pbaron2/tracker-lora/Tracker_LoRa/test1.PNG

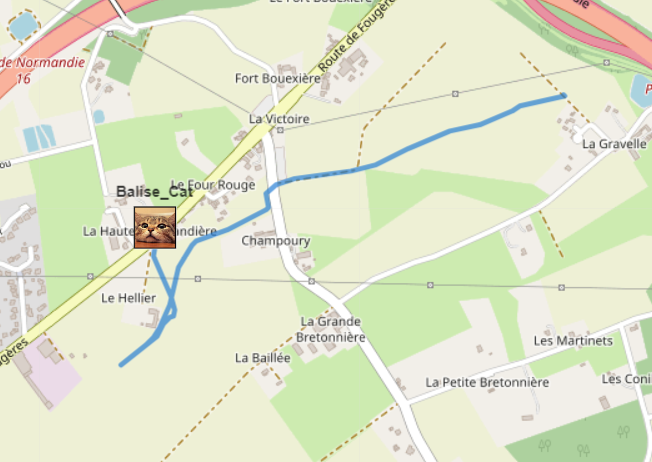
Tracker_LoRa/test1.PNG
