pbaron2/tracker-lora/Tracker_LoRa/chat.PNG

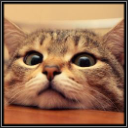
Tracker_LoRa/chat.PNG
