pbaron2/tracker-lora/Tracker_LoRa/IoT_BELIS_MJABRI_BARON_Tracker_LoRa.pptx

## Mineure IoT

Balise de géolocalisation

## Introduction

La balise de géolocalisation
Pourquoi ?

## Introduction

Localisation d’animaux de compagnie

Lien avec la télécommunication

La balise de géolocalisation
Pourquoi ?

## Cahier des charges

Grande portée (1~10 km)

Faible consommation

Taille réduite

## Choix du LoRa

LoRa

Protocole en vogue

868MHz
(bande libre)

Faible débit
(250 – 11k b/s)

Libre

Faible consommation

Grande portée (1~10 km)

## Outils de conception

Programmation des LoPy4
avec
Atom
via
PyMakr
en
MicroPython

## Architecture

GPS

PyCom LoPy4
Balise

  - Met et forme les trames NMEA du GPS
  - Autonome

PyCom LoPy4
Gateway

  - Calcule la puissance du signal reçu

WiFi / MQTT

AWS
Thingsboard

  - Stocke et met et forme les données reçues

Utilisateur

UART

LoRa

Web

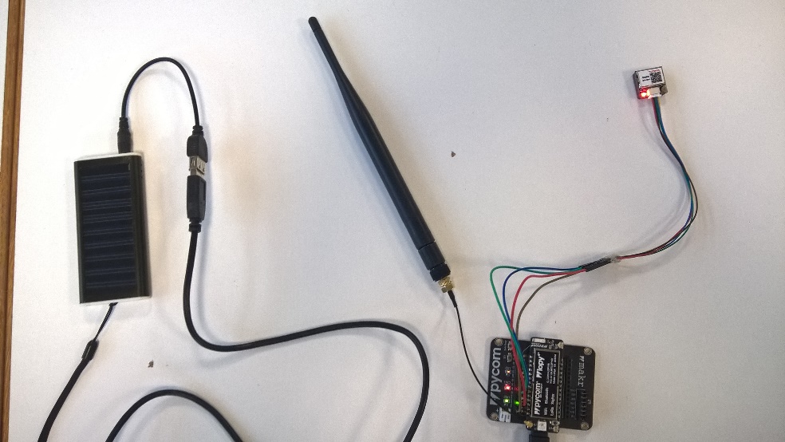
[picture p6: figure]
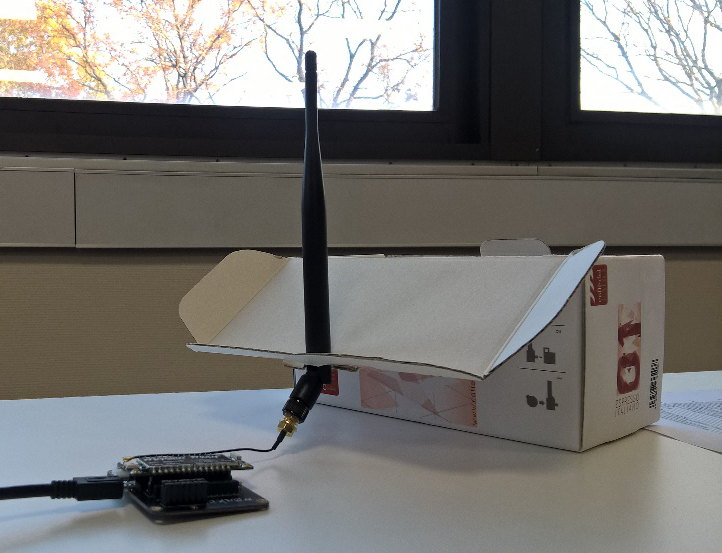
[picture p7: figure]
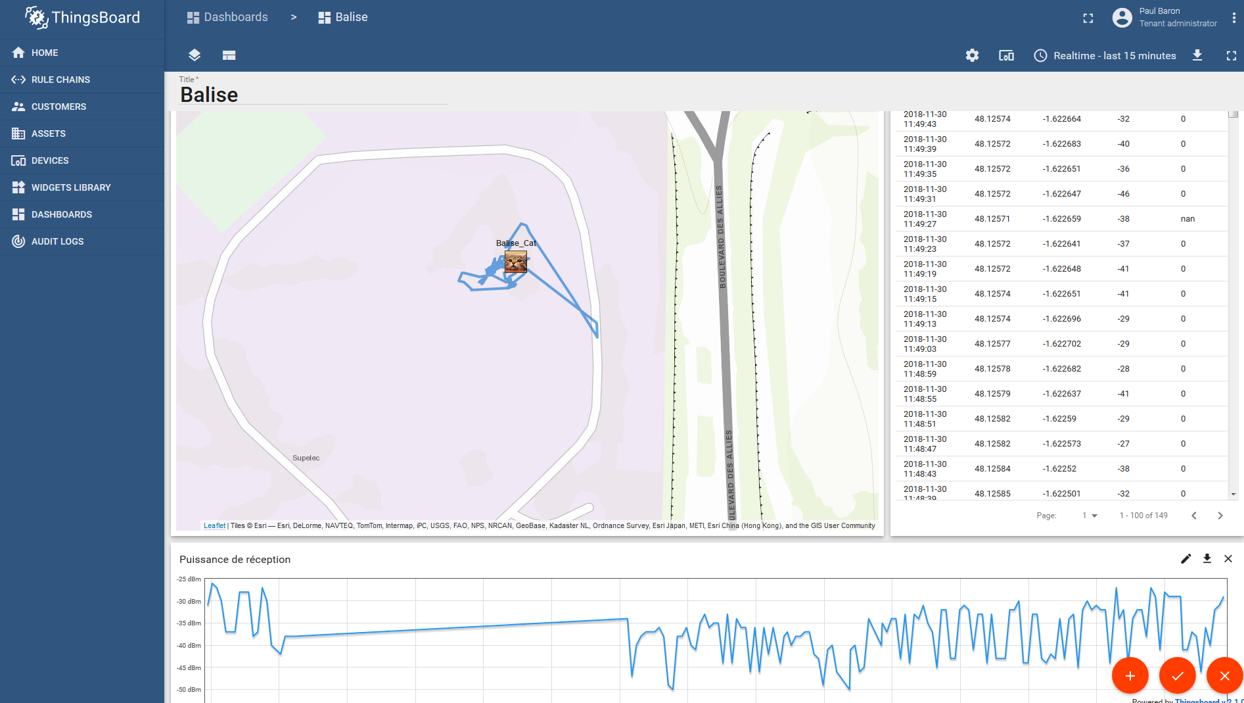
[picture p8: figure]

## Application

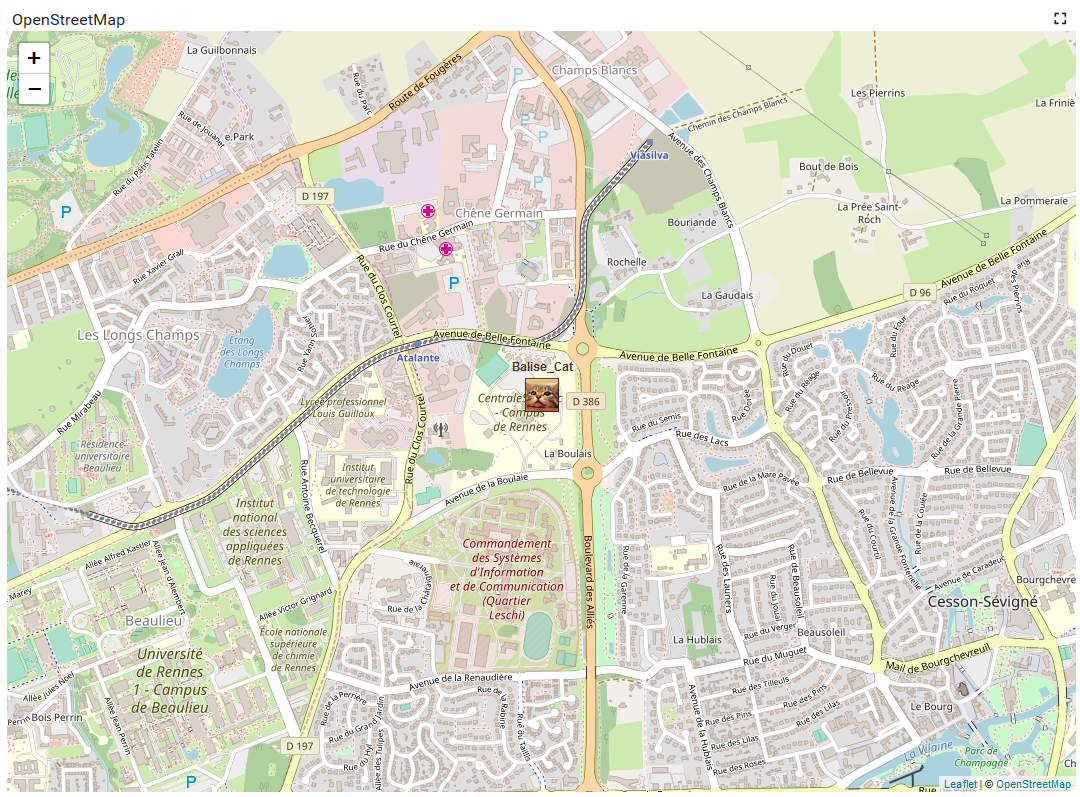
[picture p9: figure]

- Localisation à Supelec
- Intérieur : précision plus faible
- Observation d’un temps d’initialisation

## Application

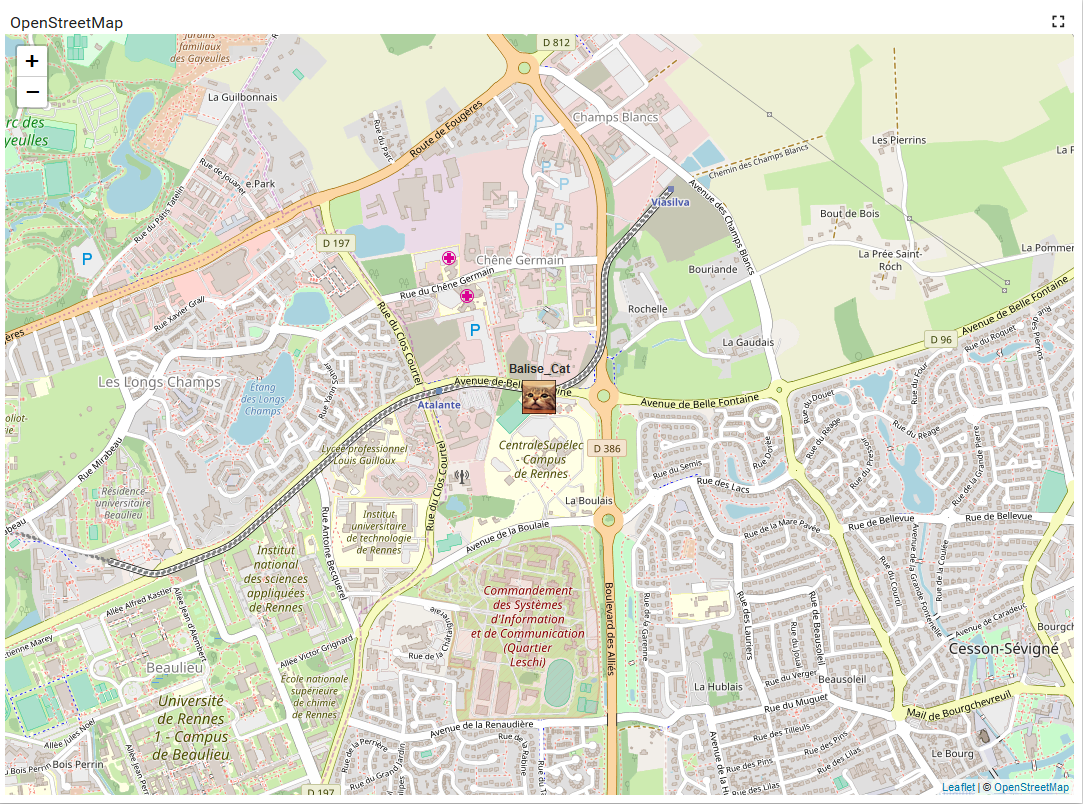
[picture p10: figure]

- Localisation depuis la résidence
- Signal toujours reçu
- Station de base = salle d’IOT, près de l’amphi 1A

## Application

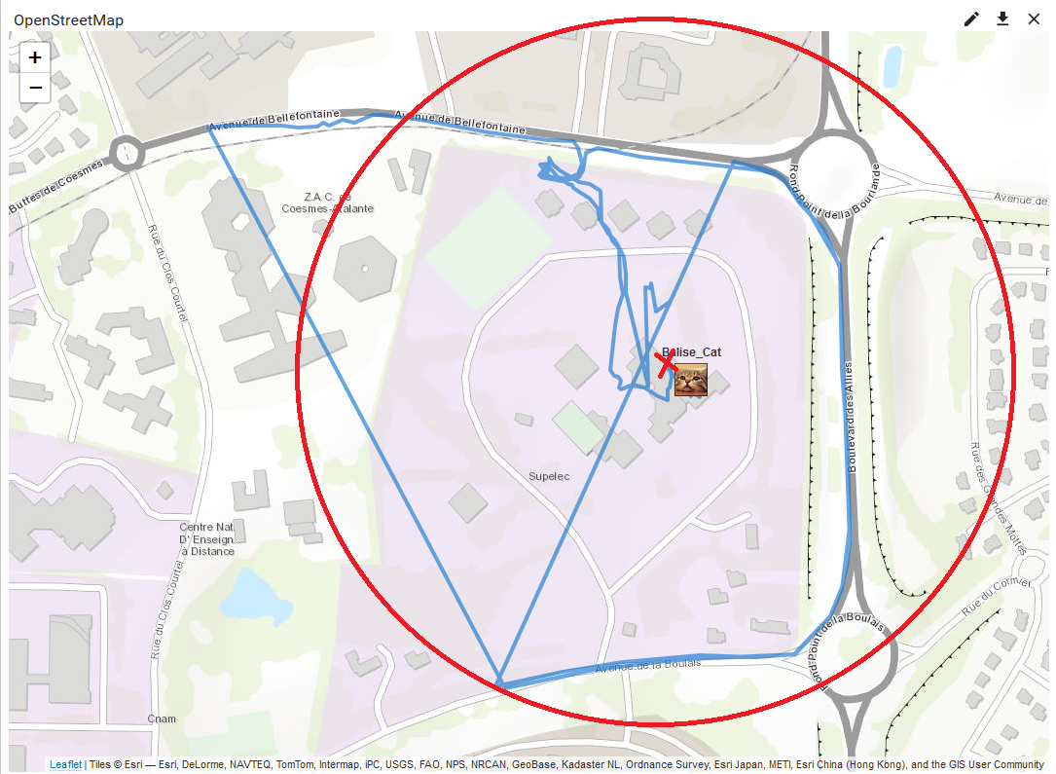
[picture p11: figure]

- Localisation autour du campus
- Signal perdu au passage derrière Orange Labs
- Tracé précis

## Prolongements

Objectifs pour la suite

Augmentation de la portée

Réduction de la taille

Amélioration de la consommation

Développement de l’accès web

## Merci de votre attention Des questions ?
