pbaron2/tracker-lora/Tracker_LoRa/e32_rf_setting_init.PNG

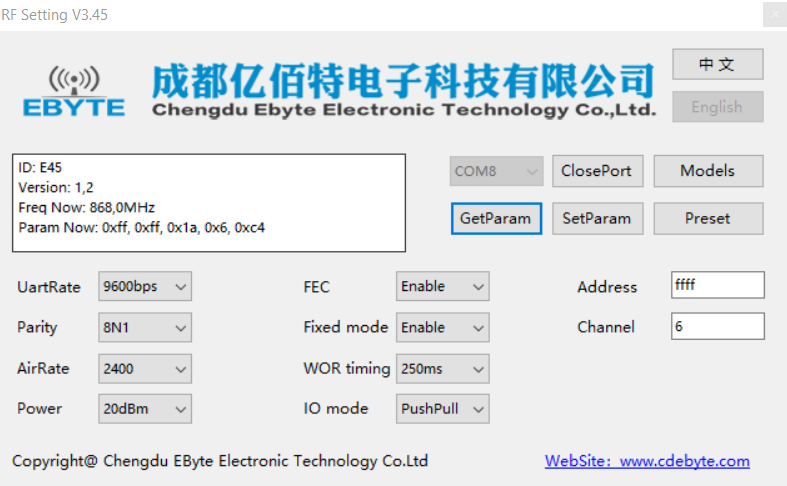
Tracker_LoRa/e32_rf_setting_init.PNG
