pbaron2/tracker-lora/Tracker_LoRa/rf_96_snif1.PNG

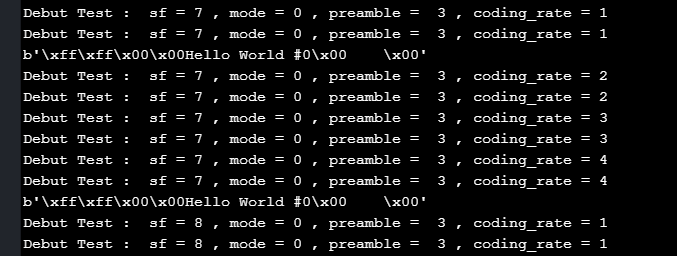
Tracker_LoRa/rf_96_snif1.PNG
