pbaron2/tracker-lora/Tracker_LoRa/mesures_lora.xlsx

Sheet: Portée
Id | Antenne Device | Antenne Base | SF | TX Power (dBm) | Bande Passante (kHz) | Preamble | Frequence (MHz) | Coding Rate | LOS | Débit (kb/s) | Dmax 1 (m) | Dmax 2 (m) | Dmax 3 (m) | Dmax 4 (m) | Dmax 5 (m) | Dmax 6 (m) | Dmax 7 (m) | Dmax 8 (m) | Dmax moyen (m) | Commentaire
0 | 3 | 1 | 12 | 23 | 125.000 | 4 | 868.850 | 0.8 | oui | 0.293 | 1300 |  |  |  |  |  |  |  | 1300 | caché par une colline après 600m

Sheet: Antennes2
Antenne | RX Power 1 | RX Power 2 | RX Power 3 | RX Power 4 | RX Power 5 | RX Power Moy | Connecteur | Commentaire
3 |  |  |  |  |  |  | male | utilisée sur le device pour les mesures
1 | -55 | -50 | -51 | -52 | -52 | -52 | femelle | pour la base
6 | -52 | -55 | -57 | -61 | -59 | -56.8 | male
12 | -57 | -57 | -57 | -57 | -57 | -57 | femelle
5 | -53 | -61 | -60 | -58 | -58 | -58 | male
13 | -60 | -61 | -61 | -60 | -59 | -60.2 | male
14 | -58 | -63 | -64 | -61 | -55 | -60.2 | femelle
9 | -61 | -60 | -64 | -64 | -63 | -62.4 | male
10 | -64 | -61 | -68 | -61 | -60 | -62.8 | femelle
4 | -70 | -63 | -62 | -62 | -61 | -63.6 | femelle
7 | -62 | -63 | -63 | -62 | -70 | -64 | male
11 | -66 | -68 | -68 | -68 | -66 | -67.2 | male
2 | -79 | -79 | -79 | -79 | -78 | -78.8 | male
8 | -87 | -89 | -89 | -93 | -87 | -89 | male
Antenne | RX Power 1 | RX Power 2 | RX Power 3 | RX Power 4 | RX Power 5 | RX Power Moy | Connecteur | Commentaire
1 | -45 | -44 | -41 | -41 | -42 | -42.6 | femelle | avec adaptateur
3 | -47 | -46 | -47 | -47 | -46 | -46.6 | male | pour le device
6 | -48 | -49 | -49 | -47 | -48 | -48.2 | male
1 |  |  |  |  |  |  | femelle | utilisée sur la base pour les mesures
 |  | 1 - défaut | 2 3 4 5 6 7 8 9 10 11 12 13 |  |  |  |  | 14 - star_wars

Sheet: Consomation
Etat lors de la mesure | Consommation (5min) (Wh) | Consommation (10min) (Wh) | Courant en sleep (mA) | Courant actif (mA) | Autonomie h (5min) | Autonomie h (10min) | Commentaire | Capacite de batterie (mAh) : | 2000
Non optimisé | 0.092 |  |  | 250 | 6.0 |  |  | Tension de la batterie (V) : | 3.3
Non optimisé + sans debug | 0.095 | 0.189 |  |  | 5.8 | 5.8
Sleep 5s après chaque envoi | 0.040 | 0.082 |  |  | 13.7 | 13.4
Sleep 5s après chaque envoi + LoRa sleep | 0.040 |  |  |  | 13.7
Sleep 10s après chaque envoi | 0.036 |  | 55 | 100-250 | 15.3
Sleep 30s après chaque envoi | 0.029 |  | 55 | 100-250 | 19.0
Sleep 60s après chaque envoi | 0.031 | 0.06 |  |  | 17.7 | 18.3
Sleep 30s après chaque envoi + send non bloquant | 0.028 |  |  |  | 19.6 |  | Pas de réception
Sleep 30s après chaque envoi + noWiFi + noBLT | 0.030 |  |  |  | 18.3
Sleep 5s après chaque envoi + noWiFi + noBLT | 0.041 |  |  |  | 13.4
Sleep 5s après chaque envoi + 40MHz flash | 0.039 |  |  |  | 14.1
Sleep 5s après chaque envoi + reset LoRa en sleep | 0.043 |  |  |  | 12.8
Sleep 5s après chaque envoi + Rx_single + short init | 0.028 | 0.056 | 18-40 | 90-230 | 19.6 | 19.6
Sleep max (18min) | 0.010 | 0.019 | 18-40 |  | 55.0 | 57.9
Sleep 5s après chaque envoi + LoRaSleep + short init | 0.033 | 0.064 | 27-65 | 90-230 | 16.7 | 17.2
Sleep 5s après chaque envoi + LoRaIdle + short init |  | 0.071 |  |  |  | 15.5
Sleep 5s + attente 5s de reception de la freq d'act | 0.035 |  |  |  | 15.7
Sleep 5s + attente 1,8s de reception de la freq d'act | 0.025 | 0.055 |  |  | 22.0 | 20.0
Sleep min (4s) + attente 1,8s + gps cyclic | 0.028 | 0.055 | 18-20 | 70-230 | 19.6 | 20.0
Sleep max (18min) + attente 1,8s + gps onoff
Sleep moy (59s) + attente 1,8s + gps onoff | 0.017 |  |  |  | 32.4
