pbaron2/tracker-lora/Tracker_LoRa/test1_mesure.PNG

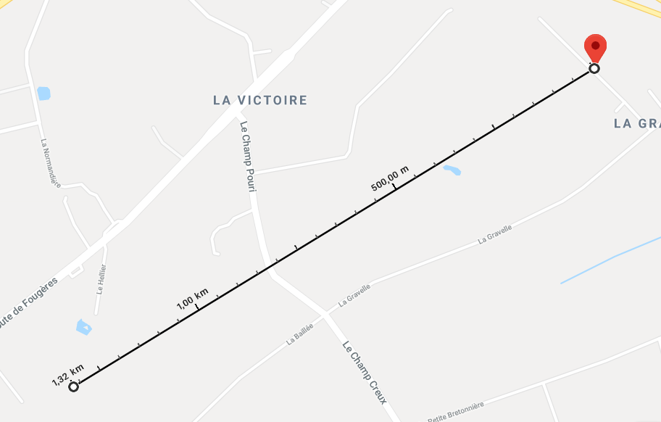
Tracker_LoRa/test1_mesure.PNG
