pbaron2/tracker-lora/Tracker_LoRa/Tracker LoRa.pdf

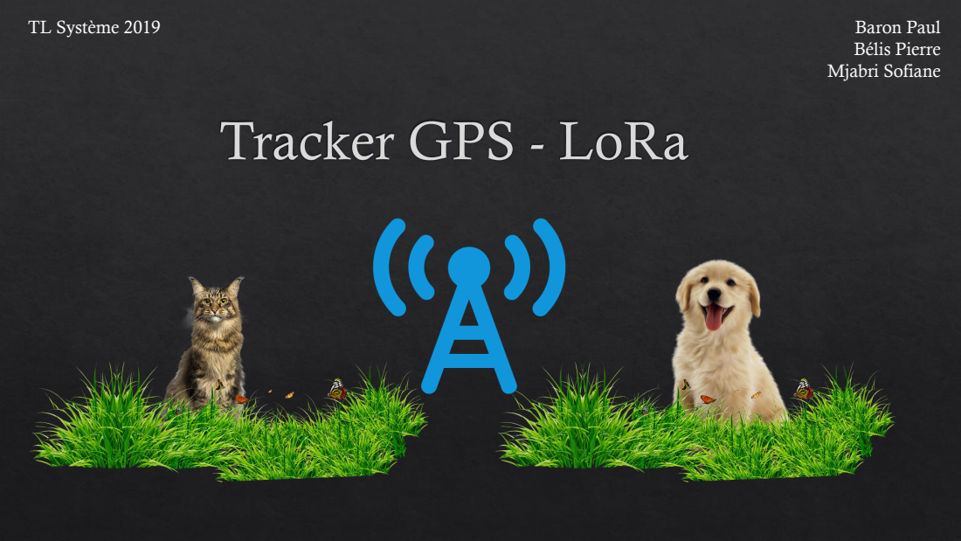
[picture p42: page 1]
TL Système 2019; Baron Paul; Bélis Pierre Mjabri Sofiane

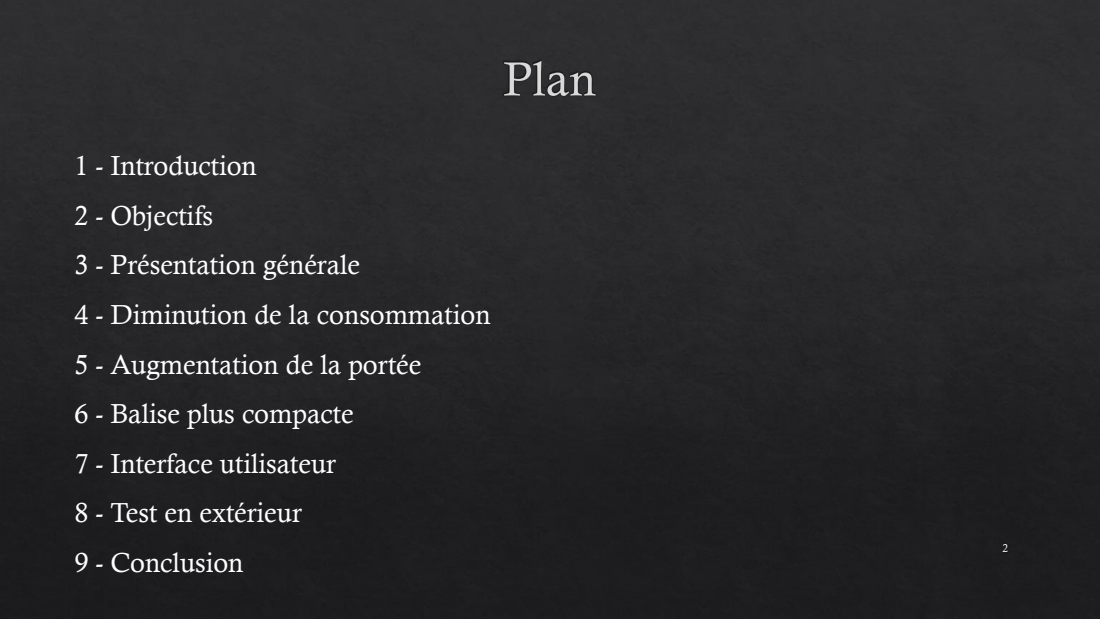
[picture p43: page 2]
- Introduction; - Objectifs; - Présentation générale; - Interface utilisateur; - Conclusion

- Diminution de la consommation

- Augmentation de la portée

- Balise plus compacte

- Test en extérieur

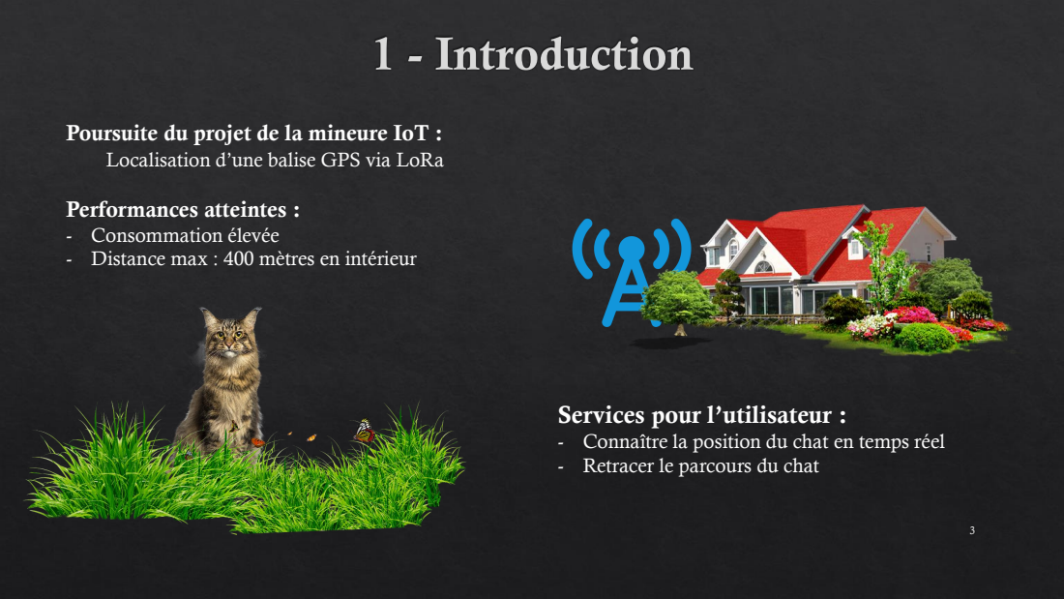
[picture p44: page 3]

Poursuite du projet de la mineure IoT :
Localisation d’une balise GPS via LoRa

Performances atteintes :
- Consommation élevée
- Distance max : 400 mètres en intérieur

Services pour l’utilisateur :
- Connaître la position du chat en temps réel
- Retracer le parcours du chat

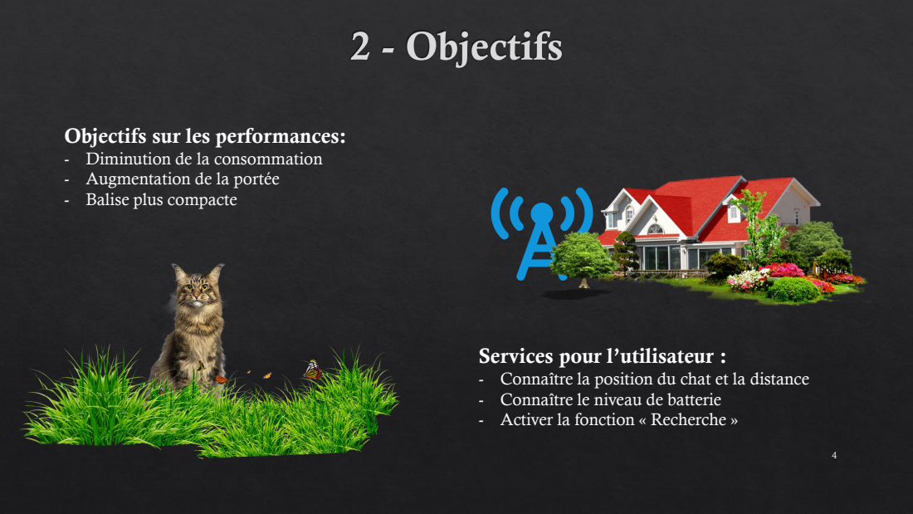
[picture p45: page 4]

Objectifs sur les performances:
- Diminution de la consommation
- Augmentation de la portée
- Balise plus compacte

Services pour l’utilisateur :
- Connaître la position du chat et la distance
- Connaître le niveau de batterie
- Activer la fonction « Recherche »

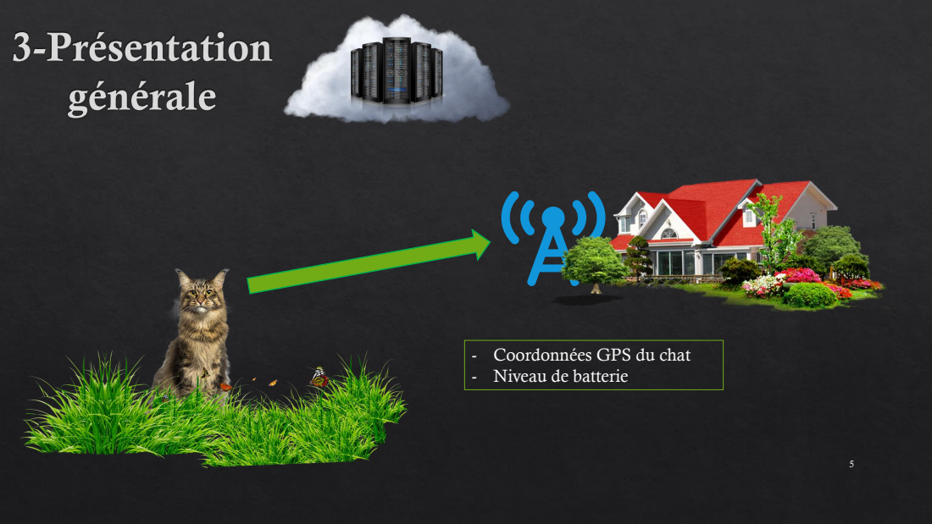
[picture p46: page 5]

- Coordonnées GPS du chat
- Niveau de batterie

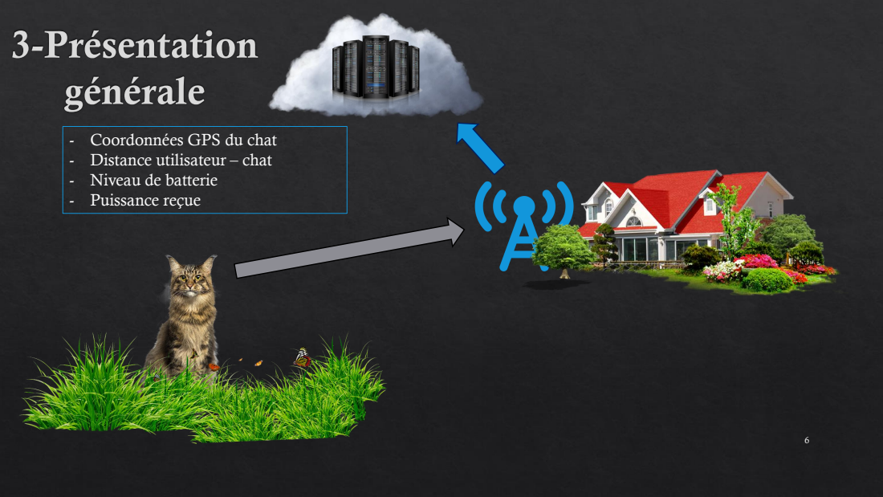
[picture p47: page 6]

- Coordonnées GPS du chat
- Distance utilisateur – chat
- Niveau de batterie
- Puissance reçue

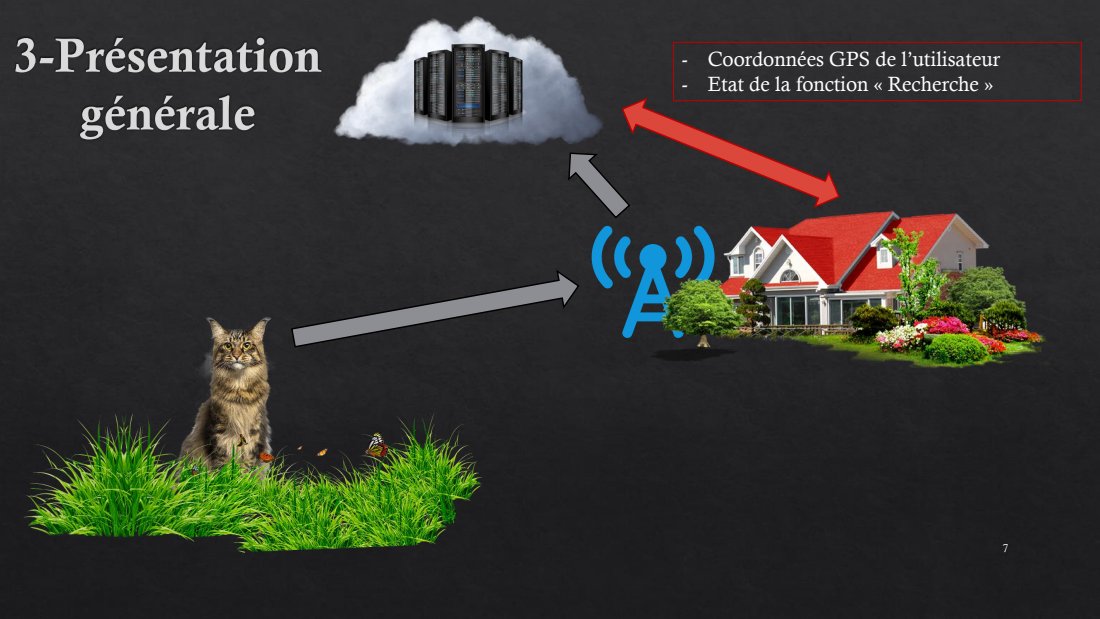
[picture p48: page 7]

- Coordonnées GPS de l’utilisateur
- Etat de la fonction « Recherche »

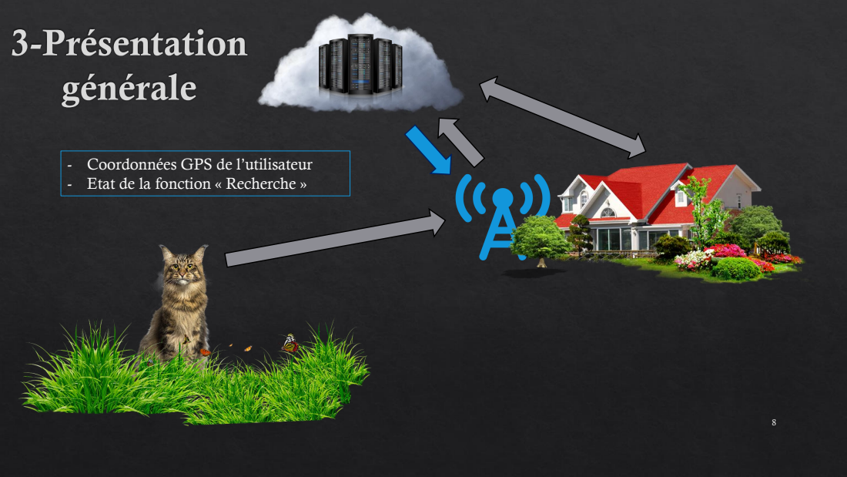
[picture p49: page 8]

- Coordonnées GPS de l’utilisateur
- Etat de la fonction « Recherche »

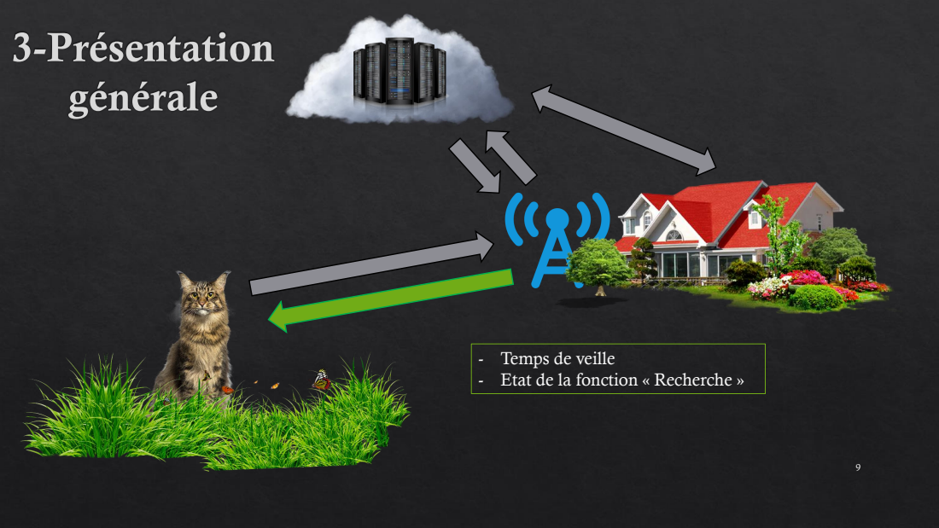
[picture p50: page 9]

- Temps de veille
- Etat de la fonction « Recherche »

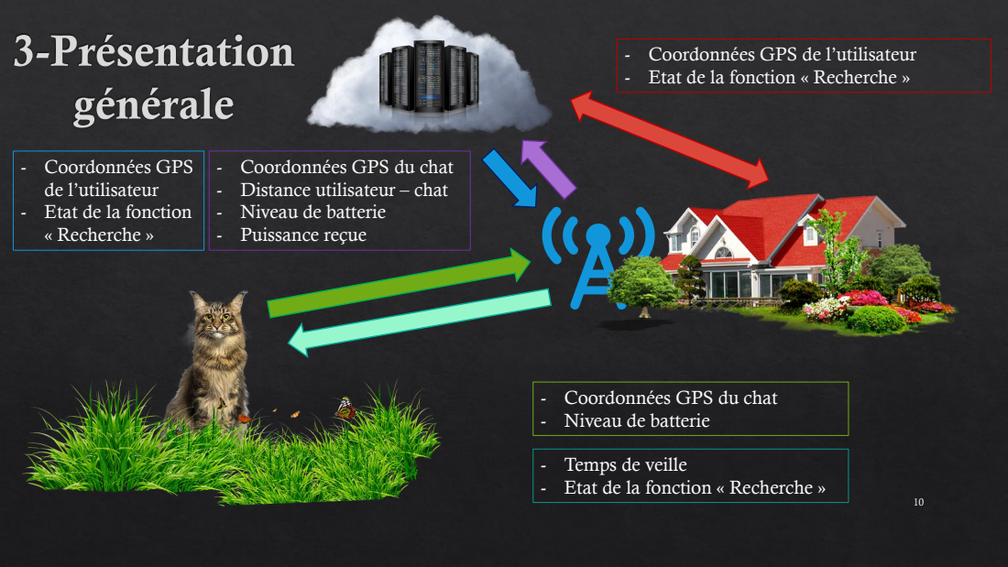
[picture p51: page 10]

- Coordonnées GPS de l’utilisateur
- Etat de la fonction « Recherche »

- Coordonnées GPS
de l’utilisateur
- Etat de la fonction
« Recherche »

- Coordonnées GPS du chat
- Distance utilisateur – chat
- Niveau de batterie
- Puissance reçue

- Temps de veille

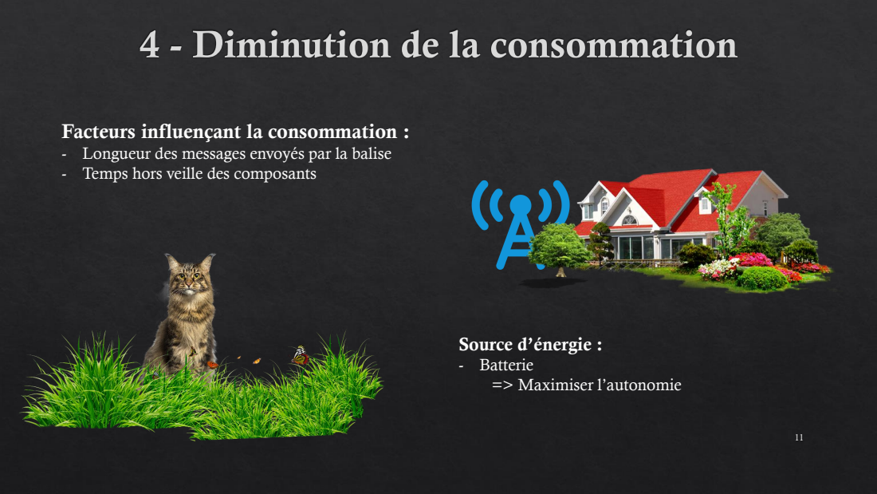
[picture p52: page 11]
Source d’énergie : - Batterie => Maximiser l’autonomie

Facteurs influençant la consommation :
- Longueur des messages envoyés par la balise
- Temps hors veille des composants

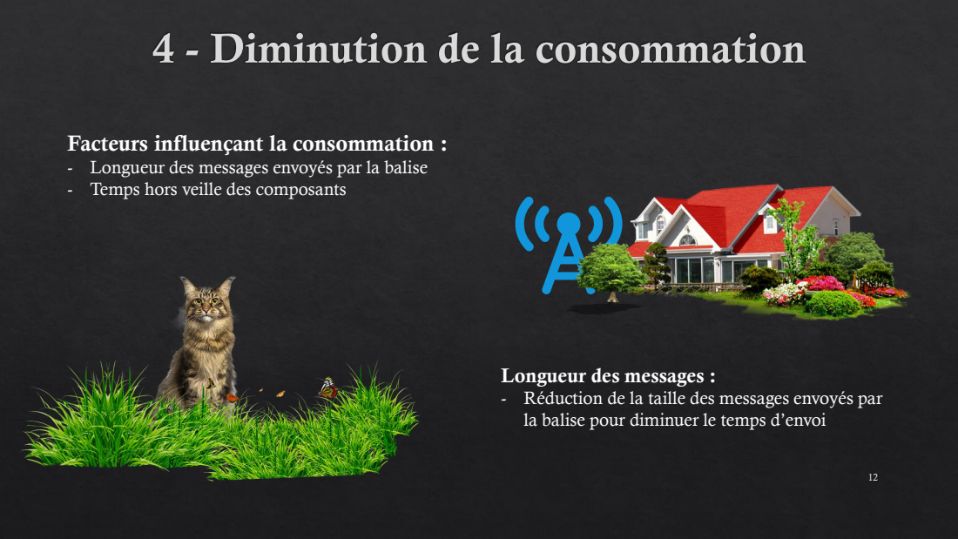
[picture p53: page 12]

Facteurs influençant la consommation :
- Longueur des messages envoyés par la balise
- Temps hors veille des composants

Longueur des messages :
- Réduction de la taille des messages envoyés par
la balise pour diminuer le temps d’envoi

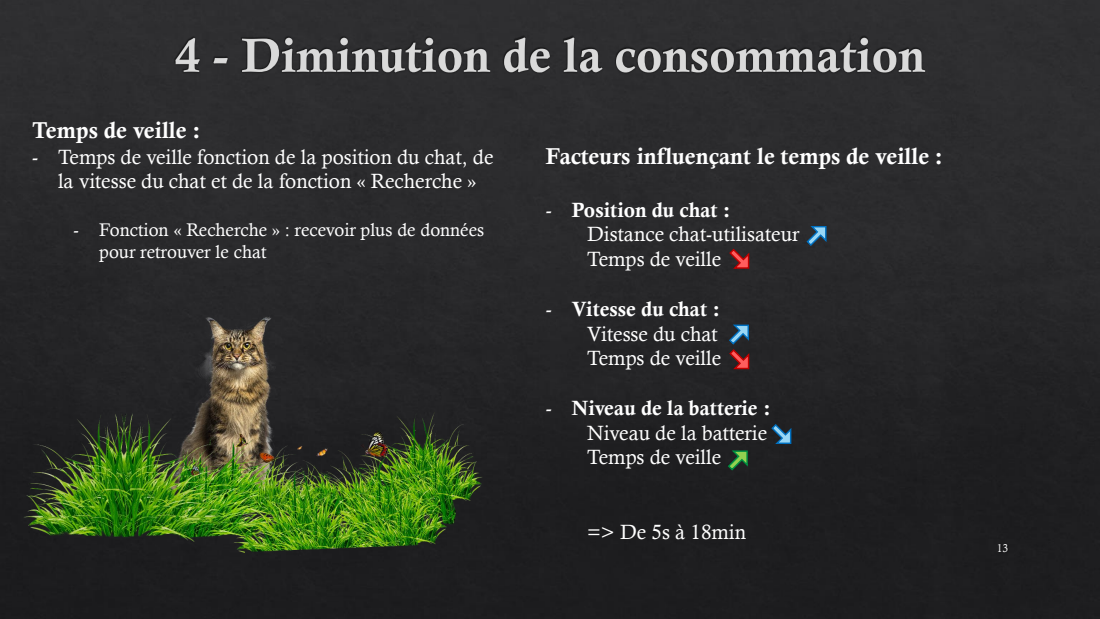
[picture p54: page 13]
=> De 5s à 18min

Temps de veille :
- Temps de veille fonction de la position du chat, de
la vitesse du chat et de la fonction « Recherche »

Facteurs influençant le temps de veille :

- Position du chat :
Distance chat-utilisateur
Temps de veille

- Fonction « Recherche » : recevoir plus de données
pour retrouver le chat

- Vitesse du chat :
Vitesse du chat

- Niveau de la batterie :
Niveau de la batterie

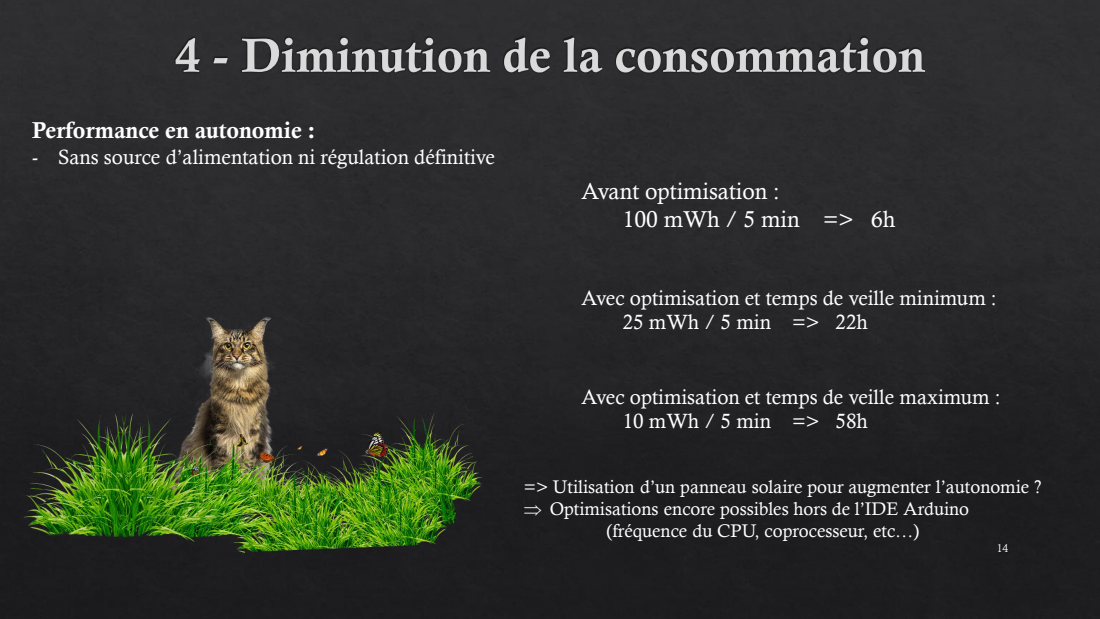
[picture p55: page 14]
Avant optimisation : 100 mWh / 5 min => 6h

Performance en autonomie :
- Sans source d’alimentation ni régulation définitive

Avec optimisation et temps de veille minimum :
25 mWh / 5 min => 22h

Avec optimisation et temps de veille maximum :
10 mWh / 5 min => 58h

=> Utilisation d’un panneau solaire pour augmenter l’autonomie ?
Þ Optimisations encore possibles hors de l’IDE Arduino

(fréquence du CPU, coprocesseur, etc…)

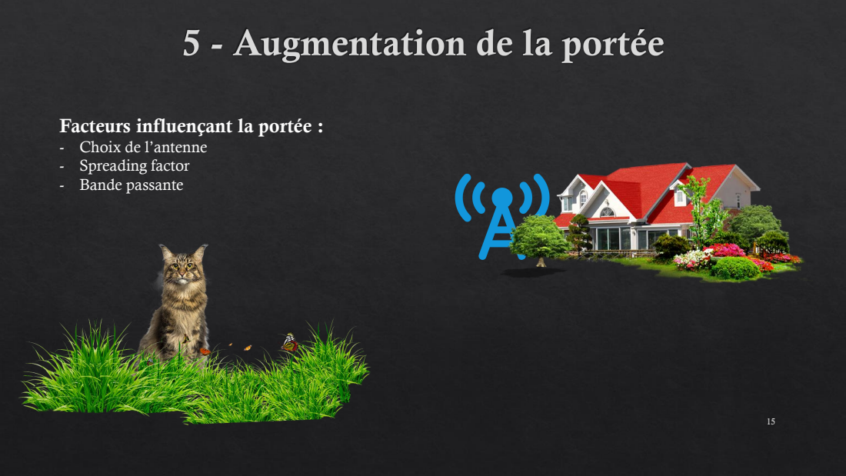
[picture p56: page 15]

Facteurs influençant la portée :
- Choix de l’antenne
- Spreading factor
- Bande passante

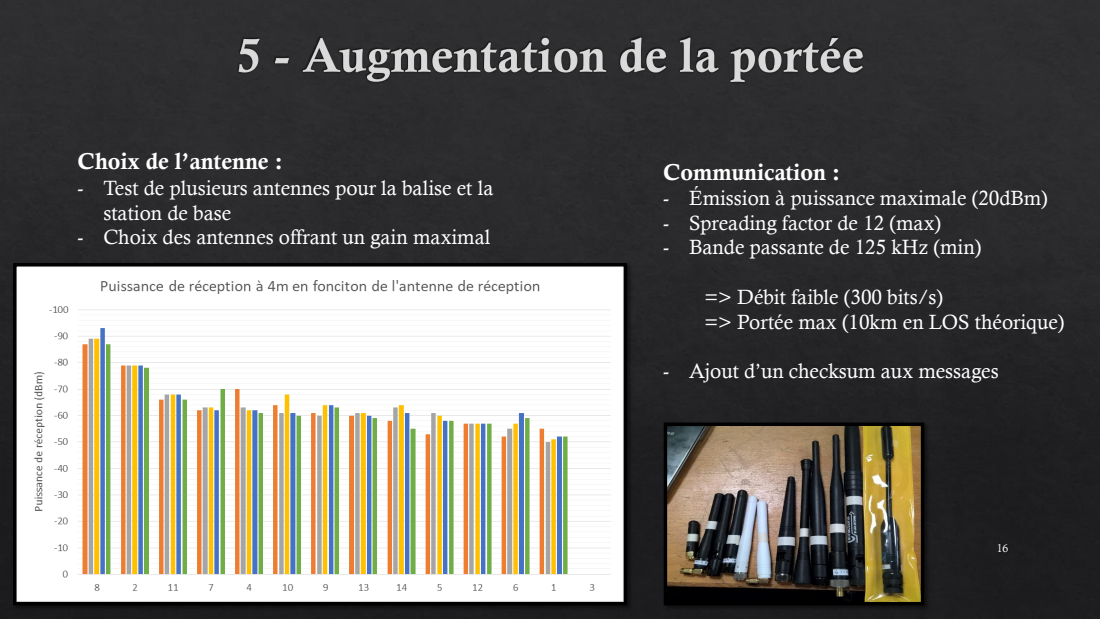
[picture p57: page 16]

Choix de l’antenne :
- Test de plusieurs antennes pour la balise et la
station de base
- Choix des antennes offrant un gain maximal

Communication :
- Émission à puissance maximale (20dBm)
- Spreading factor de 12 (max)
- Bande passante de 125 kHz (min)

=> Débit faible (300 bits/s)
=> Portée max (10km en LOS théorique)

- Ajout d’un checksum aux messages

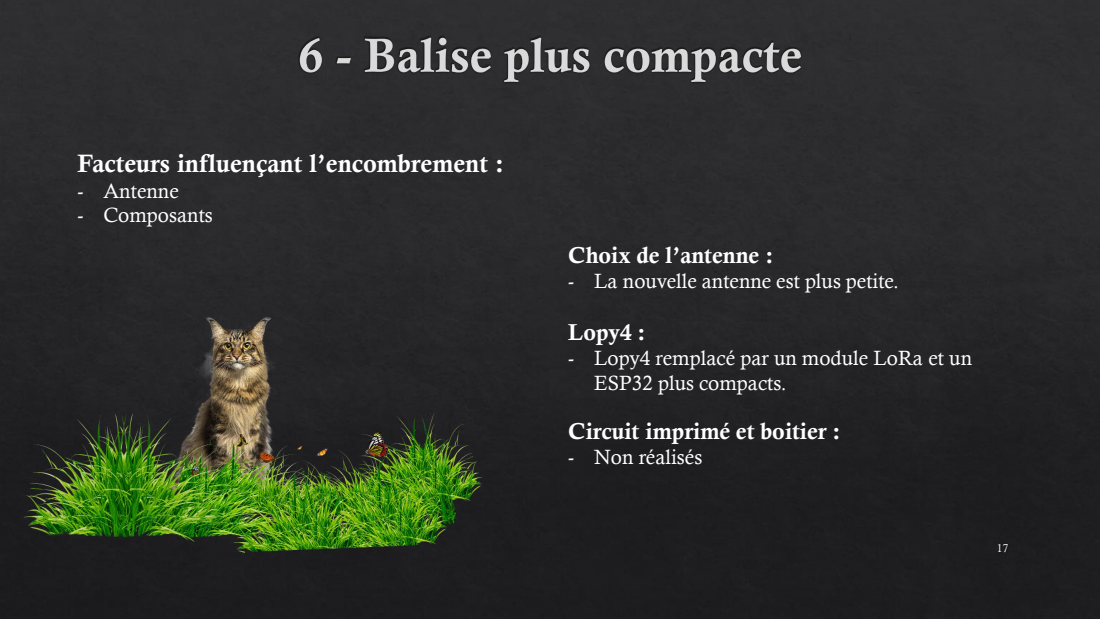
[picture p58: page 17]

Facteurs influençant l’encombrement :
- Antenne
- Composants

Choix de l’antenne :
- La nouvelle antenne est plus petite.

Lopy4 :
- Lopy4 remplacé par un module LoRa et un
ESP32 plus compacts.

Circuit imprimé et boitier :
- Non réalisés

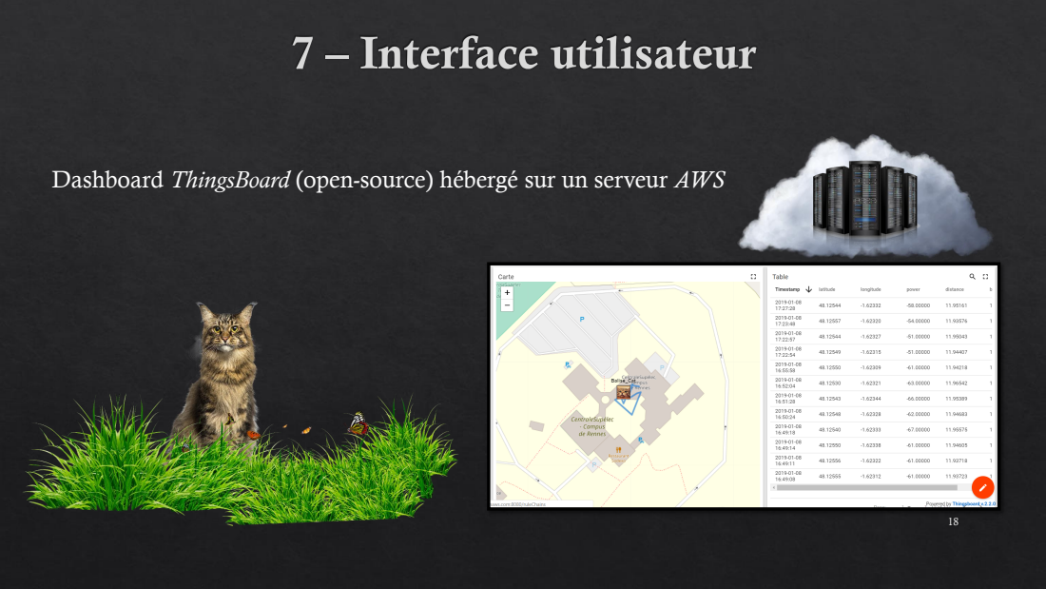
[picture p59: page 18]

Dashboard ThingsBoard (open-source) hébergé sur un serveur AWS

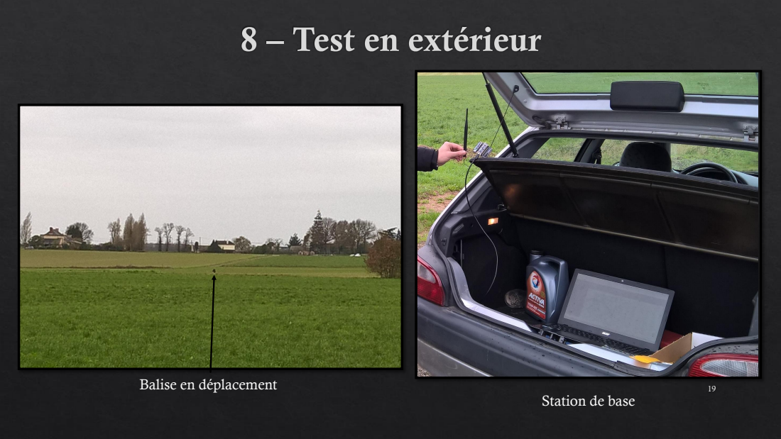
[picture p60: page 19]
Balise en déplacement

Station de base

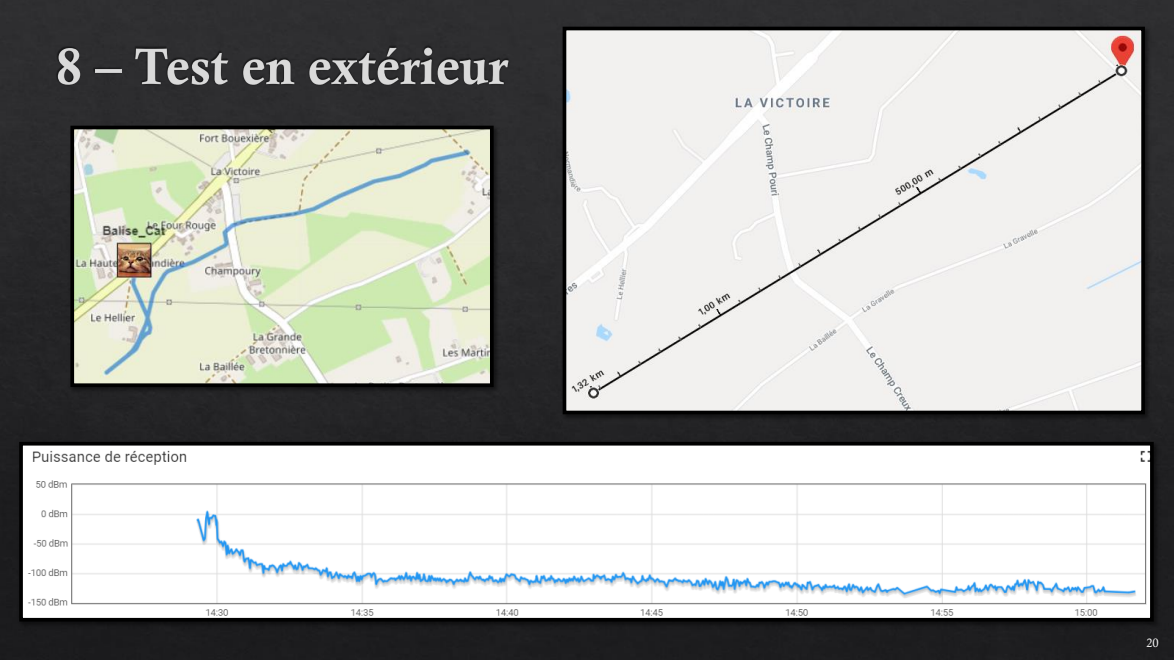
[picture p61: page 20]

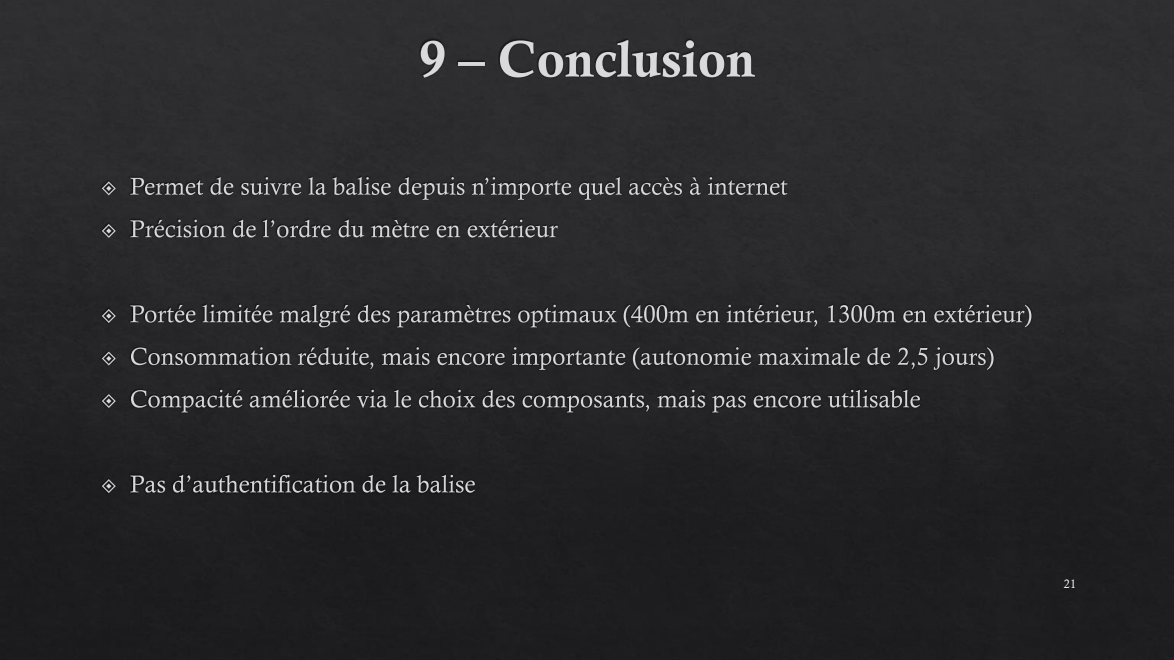
[picture p62: page 21]

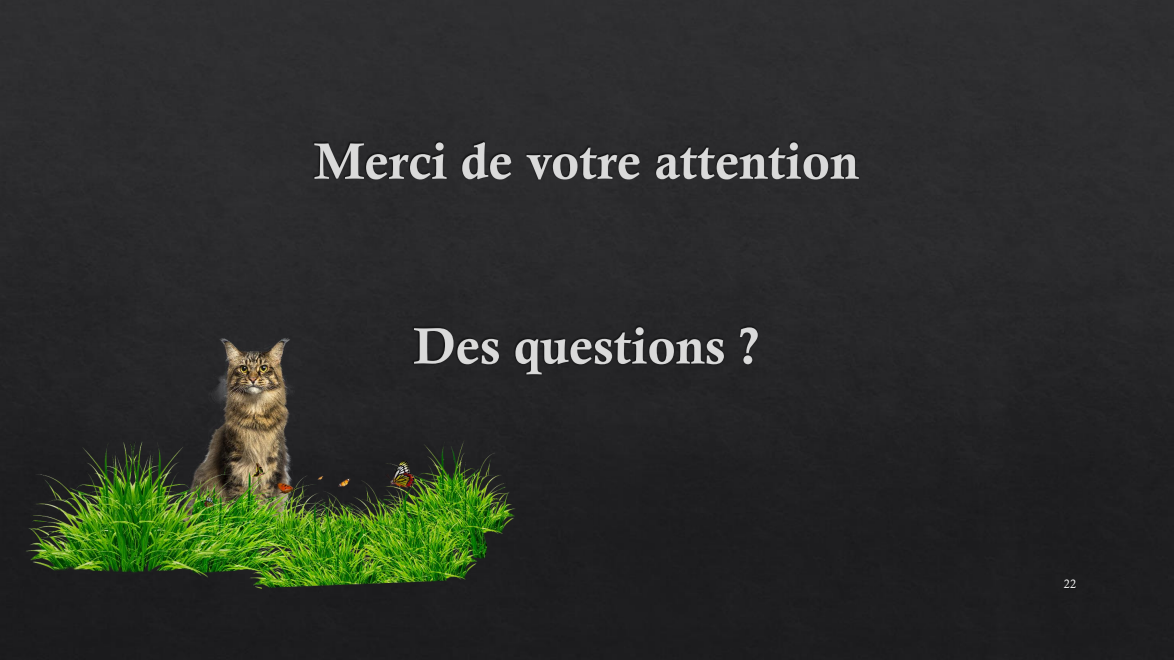
[picture p63: page 22]
